jlsajfj/MTE380/README.md

# MTE380
STM32 Programming with NUCLEO-F401RE Board
