jlsajfj/MTE380/MainBoard/MainBoard.kicad_pcb

## KiCad design MainBoard/MainBoard.kicad_pcb (2024-03-13)

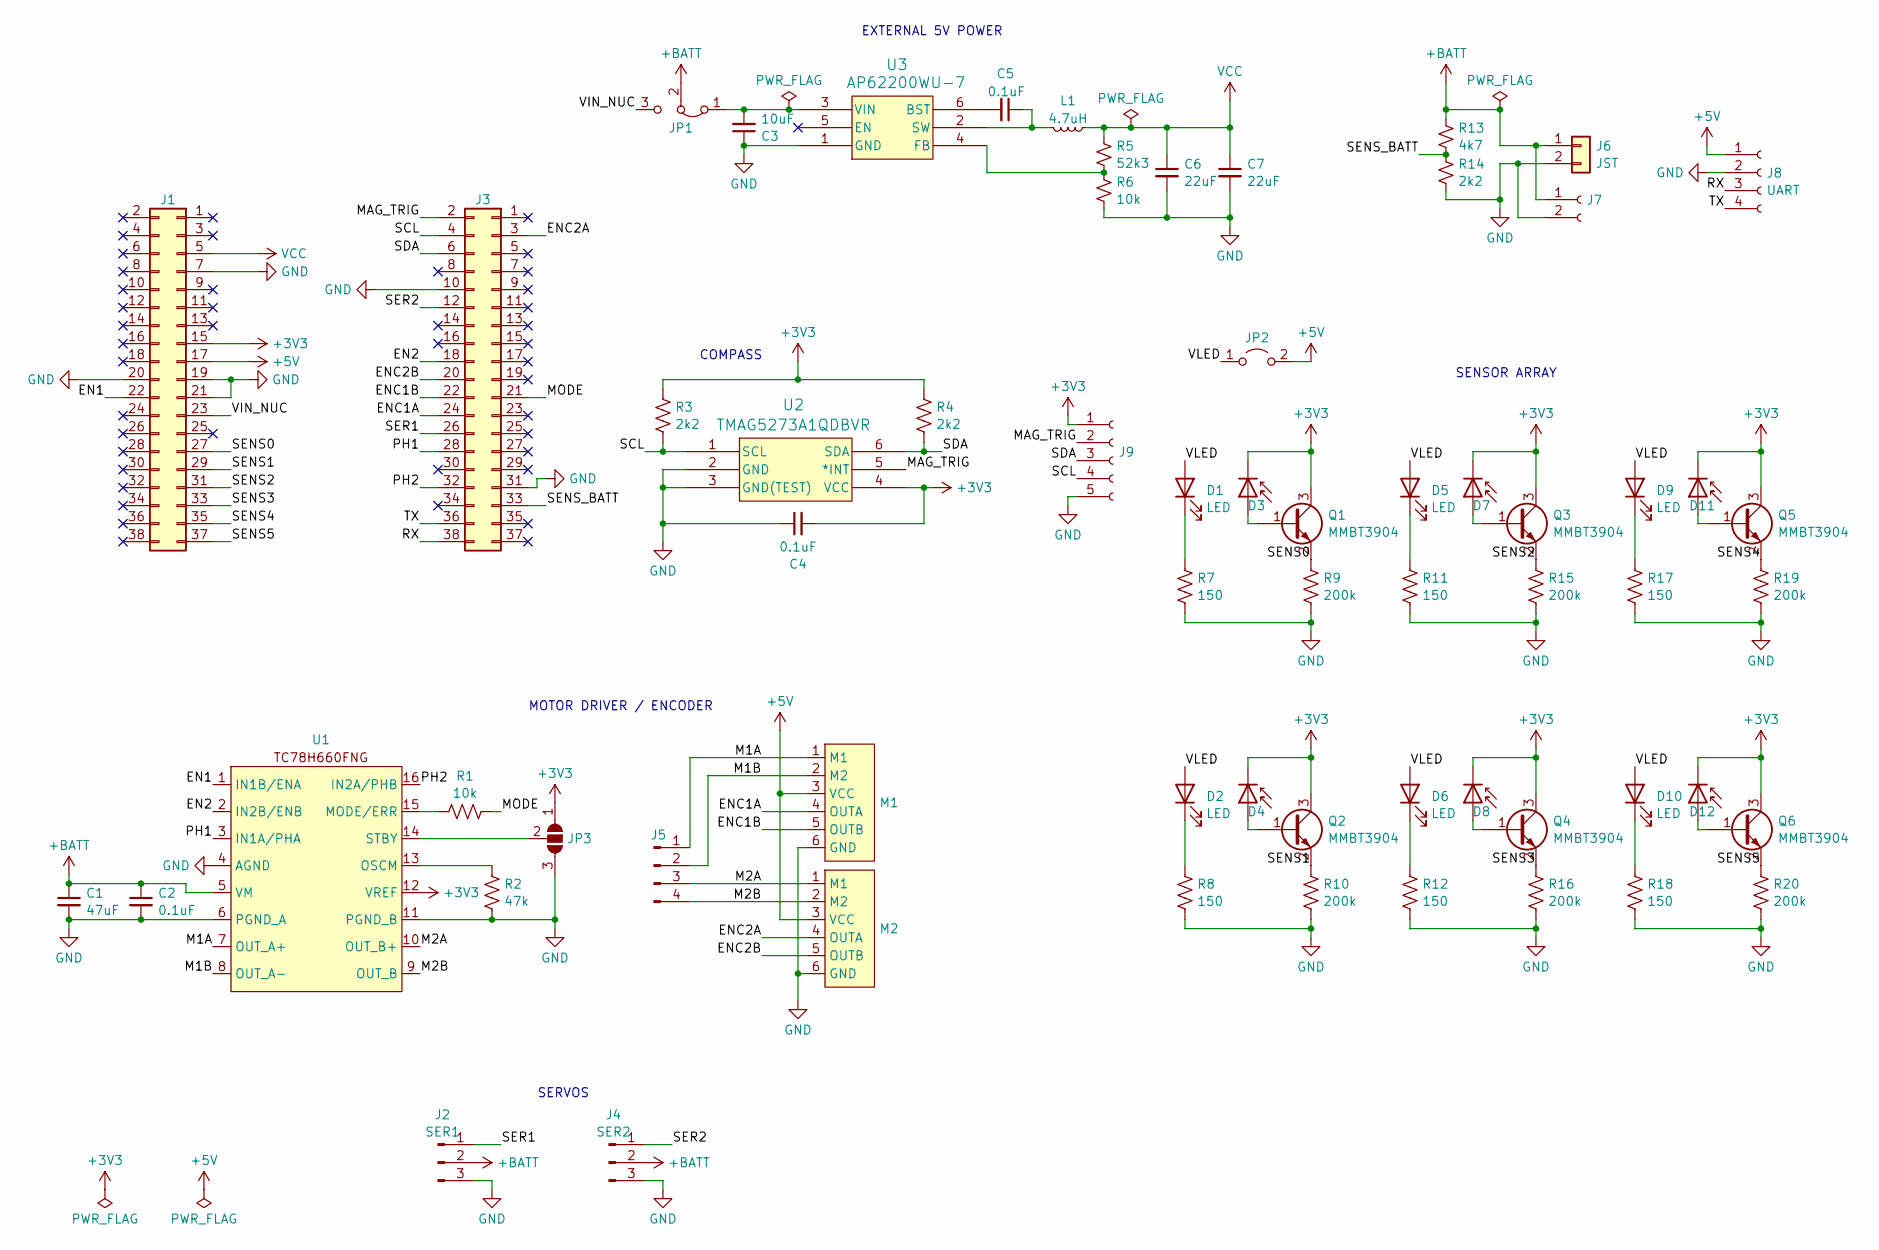
[picture p1: schematic MainBoard.kicad_sch]

Parts:
C1: 47uF; C_Radial_D5.0mm_H7.0mm_P2.00mm
C2, C4, C5: 0.1uF; C_0805_2012Metric_Pad1.18x1.45mm_HandSolder
C3: 10uF; C_0805_2012Metric_Pad1.18x1.45mm_HandSolder
C6, C7: 22uF; C_0805_2012Metric_Pad1.18x1.45mm_HandSolder
D1, D2, D5, D6, D9, D10: LED; LED_D3.0mm
D3, D4, D7, D8, D11, D12: D_Photo; LED_D5.0mm
J1, J3: Conn_02x19_Odd_Even; PinSocket_2x19_P2.54mm_Vertical
J2: SER1; PinHeader_1x03_P2.54mm_Vertical
J4: SER2; PinHeader_1x03_P2.54mm_Vertical
J5: Conn_01x04_Pin; PinHeader_1x04_P2.54mm_Horizontal
J6: JST; JST_PH_B2B-PH-K_1x02_P2.00mm_Vertical
J7: Conn_01x02_Socket; PinSocket_1x02_P2.54mm_Vertical
J8: UART; PinSocket_1x04_P2.54mm_Vertical
J9: Conn_01x05_Socket; PinHeader_1x05_P2.54mm_Vertical
JP1: Jumper_3_Bridged12; PinHeader_1x03_P2.54mm_Vertical
JP2: Jumper_2_Open; PinHeader_1x02_P2.54mm_Vertical
JP3: SolderJumper_3_Bridged12; SolderJumper-3_P2.0mm_Open_TrianglePad1.0x1.5mm
L1: 4.7uH; L_0805_2012Metric_Pad1.15x1.40mm_HandSolder
M1, M2: N20
Q1, Q2, Q3, Q4, Q5, Q6: MMBT3904; SOT-23_Handsoldering
R1, R6: 10k; R_0805_2012Metric_Pad1.20x1.40mm_HandSolder
R2: 47k; R_0805_2012Metric_Pad1.20x1.40mm_HandSolder
R3, R4, R14: 2k2; R_0805_2012Metric_Pad1.20x1.40mm_HandSolder
R5: 52k3; R_0805_2012Metric_Pad1.20x1.40mm_HandSolder
R7, R8, R11, R12, R17, R18: 150; R_0805_2012Metric_Pad1.20x1.40mm_HandSolder
R9, R10, R15, R16, R19, R20: 200k; R_0805_2012Metric_Pad1.20x1.40mm_HandSolder
R13: 4k7; R_0805_2012Metric_Pad1.20x1.40mm_HandSolder
U1: TSSOP-16_4.4x5mm_P0.65mm
U2: TMAG5273A1QDBVR; TSOT-23-6_HandSoldering
U3: AP62200WU-7; TSOT-23-6_HandSoldering

Connections:
+3V3: C4.2, D3.1 (K), D4.1 (K), D7.1 (K), D8.1 (K), D11.1 (K), D12.1 (K), J1.15, J9.1, JP3.1 (A), Q1.3 (C), Q2.3 (C), Q3.3 (C), Q4.3 (C), Q5.3 (C), Q6.3 (C), R3.1, R4.1, U1.12 (VREF), U2.4 (VCC)
+5V: J1.17, J8.1, JP2.2 (B), M1.3 (VCC), M2.3 (VCC)
+BATT: C1.1, C2.1, J2.2, J4.2, J6.1, J7.1, JP1.2 (C), R13.1, U1.5 (VM)
/EN1: J1.22, U1.1 (IN1B/ENA)
/EN2: J3.18, U1.2 (IN2B/ENB)
/ENC1A: J3.24, M1.4 (OUTA)
/ENC1B: J3.22, M1.5 (OUTB)
/ENC2A: J3.3, M2.4 (OUTA)
/ENC2B: J3.20, M2.5 (OUTB)
/M1A: J5.1, M1.1 (M1), U1.7 (OUT_A+)
/M1B: J5.2, M1.2 (M2), U1.8 (OUT_A-)
/M2A: J5.3, M2.1 (M1), U1.10 (OUT_B+)
/M2B: J5.4, M2.2 (M2), U1.9 (OUT_B)
/MAG_TRIG: J3.2, J9.2, U2.5 (*INT)
/MODE: J3.21, R1.2
/PH1: J3.28, U1.3 (IN1A/PHA)
/PH2: J3.32, U1.16 (IN2A/PHB)
/RX: J3.38, J8.3
/SCL: J3.4, J9.4, R3.2, U2.1 (SCL)
/SDA: J3.6, J9.3, R4.2, U2.6 (SDA)
/SENS0: J1.27, Q1.2 (E), R9.1
/SENS1: J1.29, Q2.2 (E), R10.1
/SENS2: J1.31, Q3.2 (E), R15.1
/SENS3: J1.33, Q4.2 (E), R16.1
/SENS4: J1.35, Q5.2 (E), R19.1
/SENS5: J1.37, Q6.2 (E), R20.1
/SENS_BATT: J3.33, R13.2, R14.1
/SER1: J2.1, J3.26
/SER2: J3.12, J4.1
/TX: J3.36, J8.4
/VIN_NUC: J1.23, JP1.3 (B)
/VLED: D1.2 (A), D2.2 (A), D5.2 (A), D6.2 (A), D9.2 (A), D10.2 (A), JP2.1 (A)
GND: C1.2, C2.2, C3.1, C4.1, C6.2, C7.2, J1.7, J1.19, J1.20, J1.21, J2.3, J3.10, J3.31, J4.3, J6.2, J7.2, J8.2, J9.5, JP3.3 (B), M1.6 (GND), M2.6 (GND), R2.2, R6.2, R7.2, R8.2, R9.2, R10.2, R11.2, R12.2, R14.2, R15.2, R16.2, R17.2, R18.2, R19.2, R20.2, U1.4 (AGND), U1.6 (PGND_A), U1.11 (PGND_B), U2.2 (GND), U2.3 (GND(TEST)), U3.1 (GND)
unnamed: D1.1 (K), R7.1
unnamed: D2.1 (K), R8.1
unnamed: D3.2 (A), Q1.1 (B)
unnamed: D4.2 (A), Q2.1 (B)
unnamed: D5.1 (K), R11.1
unnamed: D6.1 (K), R12.1
unnamed: D7.2 (A), Q3.1 (B)
unnamed: D8.2 (A), Q4.1 (B)
unnamed: D9.1 (K), R17.1
unnamed: D10.1 (K), R18.1
unnamed: D11.2 (A), Q5.1 (B)
unnamed: D12.2 (A), Q6.1 (B)
unnamed: C3.2, JP1.1 (A), U3.3 (VIN)
unnamed: JP3.2 (C), U1.14 (STBY)
unnamed: R1.1, U1.15 (MODE/ERR)
unnamed: R2.1, U1.13 (OSCM)
unnamed: C5.2, U3.6 (BST)
unnamed: R5.2, R6.1, U3.4 (FB)
unnamed: C5.1, L1.1, U3.2 (SW)
VCC: C6.1, C7.1, J1.5, L1.2, R5.1

Notes on the sheet:
COMPASS
EXTERNAL 5V POWER
SERVOS
MOTOR DRIVER / ENCODER
SENSOR ARRAY

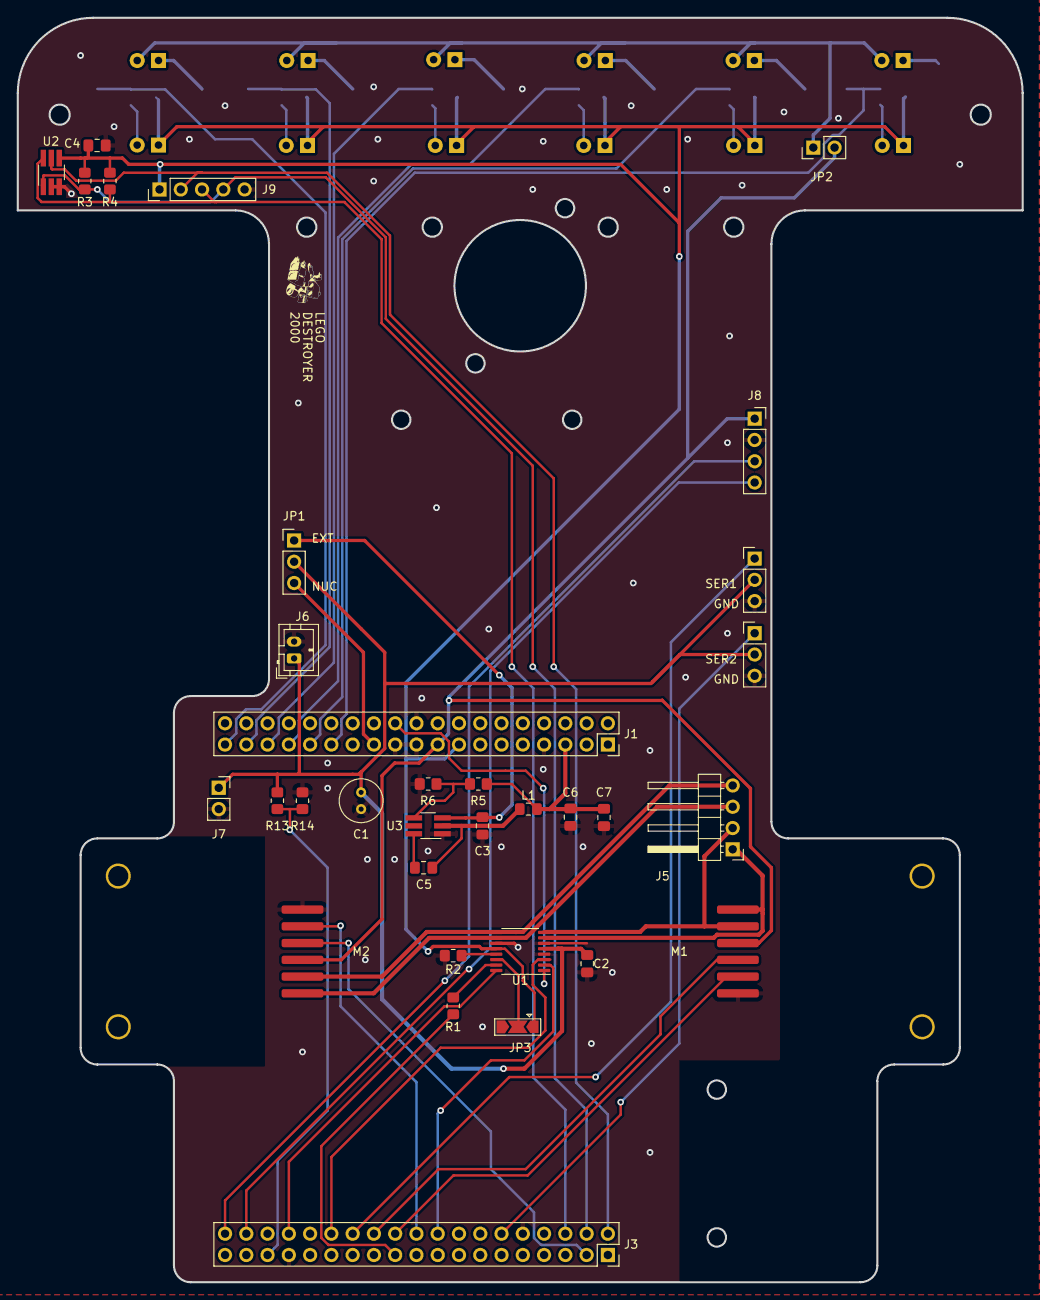
[picture p2: board MainBoard.kicad_pcb from above]

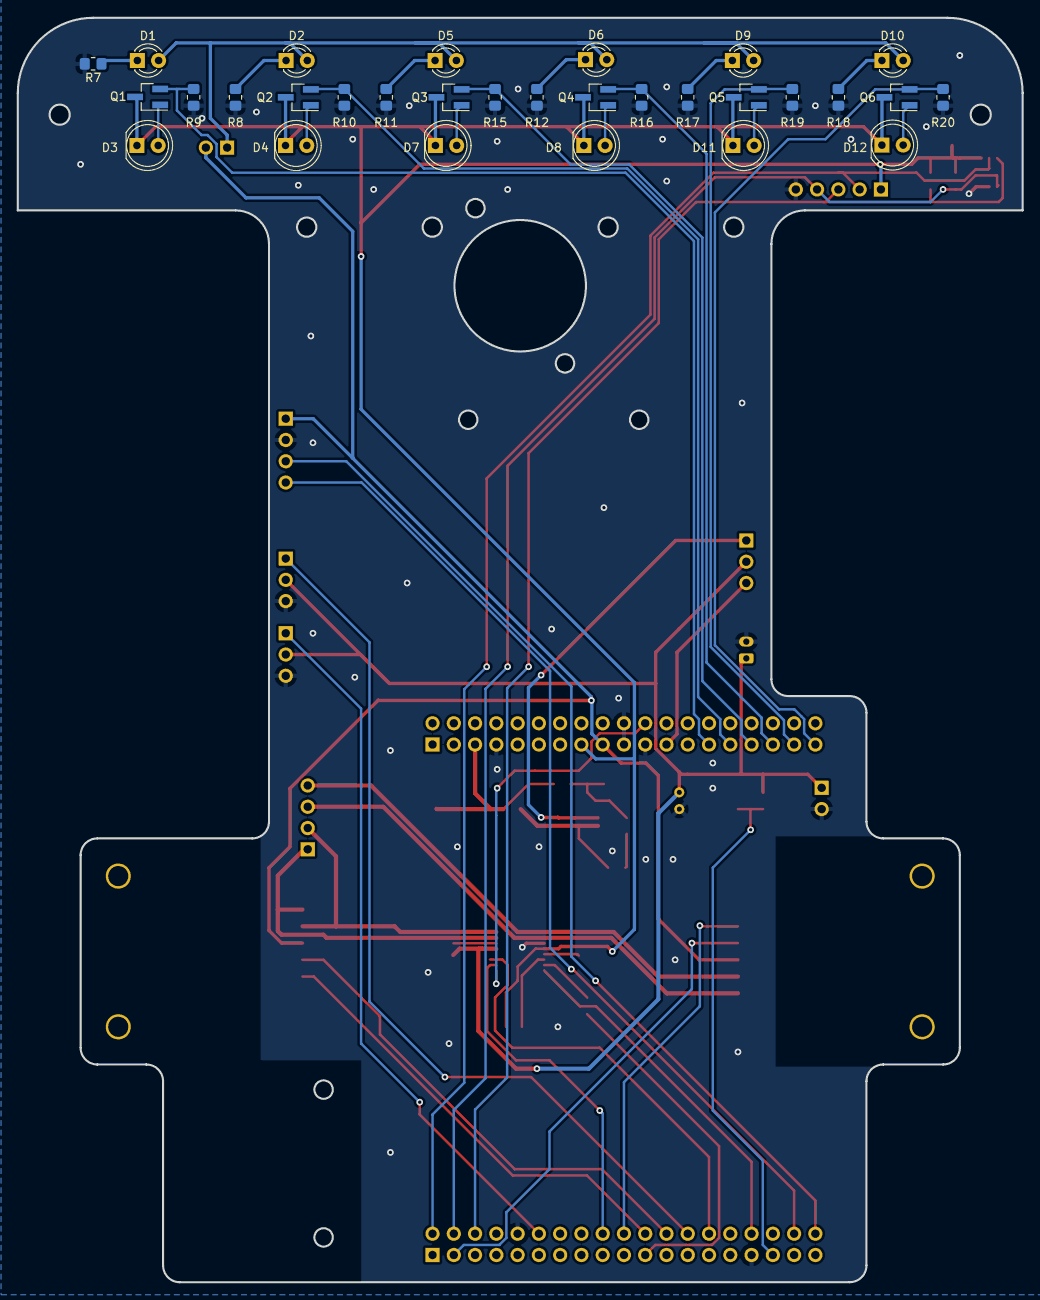
[picture p3: board MainBoard.kicad_pcb from below]

Board: 2 copper layers, 120.0 x 151.0 mm, 63 parts (30 on the bottom side), 53 nets.
