jlsajfj/MTE380/Core/Src/main.c

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
/* Includes ------------------------------------------------------------------*/
#include "main.h"
#include "adc.h"
#include "dma.h"
#include "i2c.h"
#include "tim.h"
#include "usart.h"
#include "gpio.h"

/* USER CODE BEGIN Includes */
#include "motor.h"
#include "command.h"
#include "control.h"
#include "sensor.h"
#include "flash.h"
#include "servo.h"
#include "compass.h"
#include "helper.h"
#include "config.h"
#include "state.h"
#include "telemetry.h"
#include "speed.h"
#include "music.h"
#include "button.h"

#include "stm32f4xx_hal.h"

#include <stdio.h>
/* USER CODE END Includes */


/* USER CODE BEGIN PV */
static volatile bool start_loop;
/* USER CODE END PV */

void SystemClock_Config(void);
/**
  * @brief  The application entry point.
  * @retval int
  */
int main(void)
{
  /* MCU Configuration--------------------------------------------------------*/

  /* Reset of all peripherals, Initializes the Flash interface and the Systick. */
  HAL_Init();

  /* Configure the system clock */
  SystemClock_Config();

  /* Initialize all configured peripherals */
  MX_GPIO_Init();
  MX_DMA_Init();
  MX_USART2_UART_Init();
  MX_ADC1_Init();
  MX_TIM3_Init();
  MX_TIM4_Init();
  MX_TIM2_Init();
  MX_TIM1_Init();
  MX_TIM5_Init();
  MX_I2C1_Init();
  MX_TIM9_Init();
  MX_TIM10_Init();
  /* USER CODE BEGIN 2 */

  config_load();
  sensor_init();
  button_init();
  compass_init();
  command_init();
  sm_init();
  control_init();
  servo_init();
  motor_init();
  speed_init();
  tele_init();
  music_init();

  HAL_TIM_Base_Start_IT(&htim5);

  /* USER CODE END 2 */

  /* Infinite loop */
  /* USER CODE BEGIN WHILE */
  while (1)
  {
    /* USER CODE END WHILE */

    /* USER CODE BEGIN 3 */
    while(!start_loop);
    start_loop = false;

    // order is important
    sensor_run();
    compass_run();
    button_run();
    command_run();
    sm_run();
    control_run();
    servo_run();
    motor_run();
    speed_run();
    tele_run();
    music_run();
    uart_flush();
  }
  /* USER CODE END 3 */
}

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
/* USER CODE BEGIN 4 */
void HAL_TIM_PeriodElapsedCallback(TIM_HandleTypeDef* htim) {
  if(htim == &htim5) {
    start_loop = true;
  }
  motor_timerIT(htim);
}
/* USER CODE END 4 */
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
