jlsajfj/MTE380/Core/Inc/main.h

#define B1_Pin GPIO_PIN_13
#define B1_GPIO_Port GPIOC
#define USART_TX_Pin GPIO_PIN_2
#define USART_TX_GPIO_Port GPIOA
#define USART_RX_Pin GPIO_PIN_3
#define USART_RX_GPIO_Port GPIOA
#define Sense_Batt_Pin GPIO_PIN_4
#define Sense_Batt_GPIO_Port GPIOC
#define Servo1_Pin GPIO_PIN_10
#define Servo1_GPIO_Port GPIOB
#define Servo2_Pin GPIO_PIN_13
#define Servo2_GPIO_Port GPIOB
#define MtrEnc_2A_Pin GPIO_PIN_6
#define MtrEnc_2A_GPIO_Port GPIOC
#define MtrEnc_2B_Pin GPIO_PIN_7
#define MtrEnc_2B_GPIO_Port GPIOC
#define Mag_Trig_Pin GPIO_PIN_9
#define Mag_Trig_GPIO_Port GPIOC
#define Mag_Trig_EXTI_IRQn EXTI9_5_IRQn
#define MtrEnc_1A_Pin GPIO_PIN_8
#define MtrEnc_1A_GPIO_Port GPIOA
#define MtrEnc_1B_Pin GPIO_PIN_9
#define MtrEnc_1B_GPIO_Port GPIOA
#define TMS_Pin GPIO_PIN_13
#define TMS_GPIO_Port GPIOA
#define TCK_Pin GPIO_PIN_14
#define TCK_GPIO_Port GPIOA
#define MtrDvr_Dir2_Pin GPIO_PIN_3
#define MtrDvr_Dir2_GPIO_Port GPIOB
#define MtrDvr_Dir1_Pin GPIO_PIN_4
#define MtrDvr_Dir1_GPIO_Port GPIOB
#define MtrDvr_PWM2_Pin GPIO_PIN_6
#define MtrDvr_PWM2_GPIO_Port GPIOB
#define MtrDrv_PWM1_Pin GPIO_PIN_7
#define MtrDrv_PWM1_GPIO_Port GPIOB
