jlsajfj/MTE380/Core/Src/usart.c

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
/* Includes ------------------------------------------------------------------*/
#include "usart.h"

/* USER CODE BEGIN 0 */
#include <stdbool.h>
#include <string.h>

#define UART_BUFF_SIZE 4096
static uint8_t uart_buff[UART_BUFF_SIZE * 2]; // two banks
static uint16_t uart_buff_len;
static uint8_t uart_buff_bank;
static volatile bool uart_dma_ready;
static uint16_t uart_fd;
/* USER CODE END 0 */

UART_HandleTypeDef huart2;
DMA_HandleTypeDef hdma_usart2_tx;

/* USART2 init function */

void MX_USART2_UART_Init(void)
{

  /* USER CODE BEGIN USART2_Init 0 */
  uart_buff_len = 0;
  uart_buff_bank = 0;
  uart_dma_ready = true;
  uart_fd = 1;
  /* USER CODE END USART2_Init 0 */

  huart2.Instance = USART2;
  huart2.Init.BaudRate = 115200;
  huart2.Init.WordLength = UART_WORDLENGTH_8B;
  huart2.Init.StopBits = UART_STOPBITS_1;
  huart2.Init.Parity = UART_PARITY_NONE;
  huart2.Init.Mode = UART_MODE_TX_RX;
  huart2.Init.HwFlowCtl = UART_HWCONTROL_NONE;
  huart2.Init.OverSampling = UART_OVERSAMPLING_16;
  if (HAL_UART_Init(&huart2) != HAL_OK)
  {
    Error_Handler();
  }
}

void HAL_UART_MspInit(UART_HandleTypeDef* uartHandle)
{

  GPIO_InitTypeDef GPIO_InitStruct = {0};
  if(uartHandle->Instance==USART2)
  {
    /* USART2 clock enable */
    __HAL_RCC_USART2_CLK_ENABLE();

    __HAL_RCC_GPIOA_CLK_ENABLE();
    /**USART2 GPIO Configuration
    PA2     ------> USART2_TX
    PA3     ------> USART2_RX
    */
    GPIO_InitStruct.Pin = USART_TX_Pin|USART_RX_Pin;
    GPIO_InitStruct.Mode = GPIO_MODE_AF_PP;
    GPIO_InitStruct.Pull = GPIO_NOPULL;
    GPIO_InitStruct.Speed = GPIO_SPEED_FREQ_LOW;
    GPIO_InitStruct.Alternate = GPIO_AF7_USART2;
    HAL_GPIO_Init(GPIOA, &GPIO_InitStruct);

    /* USART2 DMA Init */
    /* USART2_TX Init */
    hdma_usart2_tx.Instance = DMA1_Stream6;
    hdma_usart2_tx.Init.Channel = DMA_CHANNEL_4;
    hdma_usart2_tx.Init.Direction = DMA_MEMORY_TO_PERIPH;
    hdma_usart2_tx.Init.PeriphInc = DMA_PINC_DISABLE;
    hdma_usart2_tx.Init.MemInc = DMA_MINC_ENABLE;
    hdma_usart2_tx.Init.PeriphDataAlignment = DMA_PDATAALIGN_BYTE;
    hdma_usart2_tx.Init.MemDataAlignment = DMA_MDATAALIGN_BYTE;
    hdma_usart2_tx.Init.Mode = DMA_NORMAL;
    hdma_usart2_tx.Init.Priority = DMA_PRIORITY_VERY_HIGH;
    hdma_usart2_tx.Init.FIFOMode = DMA_FIFOMODE_DISABLE;
    if (HAL_DMA_Init(&hdma_usart2_tx) != HAL_OK)
    {
      Error_Handler();
    }

    __HAL_LINKDMA(uartHandle,hdmatx,hdma_usart2_tx);

    /* USART2 interrupt Init */
    HAL_NVIC_SetPriority(USART2_IRQn, 0, 0);
    HAL_NVIC_EnableIRQ(USART2_IRQn);
  }
}

void HAL_UART_MspDeInit(UART_HandleTypeDef* uartHandle)
{

  if(uartHandle->Instance==USART2)
  {
    /* Peripheral clock disable */
    __HAL_RCC_USART2_CLK_DISABLE();

    /**USART2 GPIO Configuration
    PA2     ------> USART2_TX
    PA3     ------> USART2_RX
    */
    HAL_GPIO_DeInit(GPIOA, USART_TX_Pin|USART_RX_Pin);

    /* USART2 DMA DeInit */
    HAL_DMA_DeInit(uartHandle->hdmatx);

    /* USART2 interrupt Deinit */
    HAL_NVIC_DisableIRQ(USART2_IRQn);
  }
}

/* USER CODE BEGIN 1 */
int _write(int file, const char *ptr, int len) {
  if(file != uart_fd) return len;

  if(UART_BUFF_SIZE - uart_buff_len < len) {
    return 0;
  }

  uint8_t *addr = uart_buff + uart_buff_len + uart_buff_bank * UART_BUFF_SIZE;
  uart_buff_len += len;

  if(len > 0) {
    memcpy(addr, ptr, len);
  }

  return len;
}

uint32_t uart_available(void) {
  return UART_BUFF_SIZE - uart_buff_len;
}

void uart_setTxFD(int fd) {
  uart_fd = fd;
}

void uart_flush(void) {
  if(uart_dma_ready && uart_buff_len > 0) {
    uint8_t bank = uart_buff_bank;
    uint16_t len = uart_buff_len;
    uart_buff_bank ^= 1;
    uart_buff_len = 0;
    uart_dma_ready = false;
    HAL_UART_Transmit_DMA(&huart2, uart_buff + bank * UART_BUFF_SIZE, len);
  }
}

void HAL_UART_TxCpltCallback(UART_HandleTypeDef * huart) {
  uart_dma_ready = true;
}
/* USER CODE END 1 */
