jlsajfj/MTE380/Core/Src/flash.c

#include "flash.h"

#include "stm32f4xx_hal.h"

#include <stdint.h>
#include <stddef.h>
#include <string.h>

__attribute__((__section__(".user_flash"))) static const uint8_t flash[128*1024];

HAL_StatusTypeDef flash_erase(void) {
  HAL_FLASH_Unlock();

  FLASH_EraseInitTypeDef erase_config;
  erase_config.TypeErase = FLASH_TYPEERASE_SECTORS;
  erase_config.Sector = 7;
  erase_config.NbSectors = 1;
  erase_config.VoltageRange = FLASH_VOLTAGE_RANGE_3;

  uint32_t page_error;
  HAL_StatusTypeDef status = HAL_FLASHEx_Erase(&erase_config, &page_error);

  HAL_FLASH_Lock();

  return status;
}

HAL_StatusTypeDef flash_write(flash_address_E address, void *data, size_t len) {
  HAL_FLASH_Unlock();

  HAL_StatusTypeDef status = HAL_OK;
  for(size_t i = 0; i < len && status == HAL_OK; i++) {
    status = HAL_FLASH_Program(FLASH_TYPEPROGRAM_BYTE, (uint32_t) &flash + address + i, ((uint8_t*) data)[i]);
  }

  HAL_FLASH_Lock();

  return status;
}

void flash_read(flash_address_E address, void *data, size_t len) {
  memcpy(data, flash + address, len);
}
