jlsajfj/MTE380/GUI/robot.py

import struct
import sys
import threading
import time
from enum import Enum

import serial

from helper import SB, Constants


class Robot:
    State = Enum("DecoderState", ["SYNCING", "START", "STREAM", "CONFIG", "SPEED"])

    def __init__(self, dn: str = "COM4", con: bool = False):
        self.config_names = Constants.CONFIG_NAMES
        self.dn = dn
        self.s = None
        self.sw = None
        self.send_lock = threading.Condition()
        self.debug = False
        self.state = Robot.State.SYNCING
        self.cmd_ack = False

        if con:
            self.connect()

    def bug(self, val):
        self.debug = val

    def connect(self) -> bool:
        if self.s is not None:
            return
        print("connecting to device")
        self.s = serial.Serial(self.dn, 115200)
        self.state = Robot.State.SYNCING
        print("bluetooth device has been connected")
        self.s.write(b"\n")

        # first sync
        self.send("stream 1", True)
        self.read()

    def read(self):  # https://stackoverflow.com/a/7155595
        if self.debug:
            print("reading")

        sync_cnt = 0

        while self.s is not None:
            if self.state == Robot.State.SYNCING:
                if self.s.in_waiting < 1:
                    time.sleep(0.1)
                    continue

                ack = self.s.read(1)[0]
                if ack == SB.SYNC.value:
                    sync_cnt += 1
                else:
                    sync_cnt = 0

                if sync_cnt >= Constants.SYNC_COUNT:
                    print("synced")
                    self.state = Robot.State.START

            elif self.state == Robot.State.START:
                if self.s.in_waiting < 1:
                    time.sleep(0.1)
                    continue

                start = self.s.read(1)[0]

                if start == SB.SYNC.value:
                    pass

                elif start == SB.ACK.value:
                    with self.send_lock:
                        self.cmd_ack = True
                        self.send_lock.notify()

                    return start, None

                elif start == SB.NACK.value:
                    with self.send_lock:
                        self.cmd_ack = False
                        self.send_lock.notify()

                    return start, None

                elif start == SB.STREAM.value:
                    self.state = Robot.State.STREAM

                elif start == SB.CONFIG.value:
                    self.state = Robot.State.CONFIG

                elif start == SB.SPEED.value:
                    self.state = Robot.State.SPEED

                else:
                    print(f"unknown start byte {start}")

                    with self.send_lock:
                        self.cmd_ack = False
                        self.send_lock.notify()

                    self.send("stream 1", True)
                    self.state = Robot.State.SYNCING

            elif self.state == Robot.State.STREAM:
                if self.s.in_waiting < 25:
                    time.sleep(0.1)
                    continue

                data = self.s.read(25)
                data_stream = dict(
                    zip(
                        [
                            "msl",
                            "msr",
                            "mtl",
                            "mtr",
                            "mel",
                            "mer",
                            "sta",
                            "pd0",
                            "pd1",
                            "pd2",
                            "pd3",
                            "pd4",
                            "pd5",
                            "bav",
                            "mag",
                            "tis",
                        ],
                        struct.unpack("<2b2b2iB6BBBI", data),
                    )
                )

                self.state = Robot.State.START
                return SB.STREAM, data_stream

            elif self.state == Robot.State.CONFIG:
                count = len(self.config_names)
                if self.s.in_waiting < count * 8:
                    time.sleep(0.1)
                    continue

                data = self.s.read(count * 8)
                config = dict(zip(self.config_names, struct.unpack(f"<{count}d", data)))

                self.state = Robot.State.START
                return SB.CONFIG, config

            elif self.state == Robot.State.SPEED:
                if self.s.in_waiting < 2:
                    time.sleep(0.1)
                    continue

                count = struct.unpack("<H", self.s.read(2))[0]
                if self.s.in_waiting < count * 5:
                    time.sleep(0.1)
                    continue

                data = self.s.read(count * 5)
                speed_points = [
                    {"count": p[0], "speed": p[1]}
                    for p in zip(*[iter(struct.unpack("<" + count * "iB", data))] * 2)
                ]

                self.state = Robot.State.START
                return SB.SPEED, speed_points

        self.state = Robot.State.SYNCING
        return SB.NACK, None

    def send(self, cmd: str, ignore_ack: bool = False, timeout: float = 1) -> bool:
        print("sending", cmd)
        self.s.write(cmd.encode() + b"\n")

        if not ignore_ack:
            with self.send_lock:
                self.cmd_ack = False
                self.send_lock.wait(timeout=timeout)

            return self.cmd_ack

        return True

    def disconnect(self):
        print("disconnecting")
        self.s.close()
        self.s = None


def main():
    if len(sys.argv) > 1:
        r = Robot(sys.argv[1])
    else:
        r = Robot()

    r.connect()

    r.send("get")

    for i in range(20):
        r.read()

    r.send("stream 0", True)
    r.disconnect()


if __name__ == "__main__":
    main()
