jlsajfj/MTE380/(commit log)

2024-01-15 Project Creation
    Created Project with Nucleo-F401RE Board
2024-01-19 Motor driver first push
    [MTE380-SW.cfg]
2024-01-20 motor test code
2024-01-21 Motor Driver getFault and setEnabled functions
2024-01-26 adc code
2024-01-29 calibration, command system, config
2024-01-29 move more parameters to config framework
2024-01-29 make motor speed a config
2024-02-02 make sensor gains symmetric
2024-02-02 laser scanner circuit files
    [LaserScanner.kicad_pcb, LaserScanner.kicad_sch]
2024-02-11 add pid controller
2024-02-11 Update Motor PWM
    change tim2 and tim3 pre-scalers. changed pre-scaler from 84 to 2, changed auto reload register from 100 to 1024
2024-02-11 Start Servo Code
    started some servo code, will need help to finish the firmware, need to add start and stop limits to command
2024-02-12 Bunch of Changes
    Updated Baud rate to 9600, created servo toggle and all other related functions
2024-02-13 experimental turn around and add servo support in commands
2024-02-15 add encoder support
2024-02-16 add pid for motor speed and position
2024-02-16 have pid_reset caller keep track of last output
2024-02-16 add interface to get motor count
2024-02-23 main board schematics
    [LaserScanner.kicad_pcb, LaserScanner.kicad_sch, MainBoard.kicad_pcb, MainBoard.kicad_sch]
2024-02-23 add external 5V regulator
    [MainBoard.kicad_sch]
2024-02-24 use dma for serial printing
2024-02-24 bump uart rate and handle burst transmission better
2024-02-26 mainboard layout
    [MainBoard.kicad_pcb, MainBoard.kicad_sch]
2024-02-27 add logo
    [MainBoard.kicad_pcb]
2024-02-27 update routing
    [MainBoard.kicad_pcb, MainBoard.kicad_sch]
2024-03-01 fix motor pid usage
    [command.c, config.c, control.c, control.h, motor.c, motor.h, pid.c, usart.c]
2024-03-01 poc pid tuning tool
2024-03-06 update to new board
2024-03-07 add lowpass to compass calibration; add demo code
2024-03-08 add multi servo support
2024-03-10 battery voltage; add idle mode to compass
2024-03-12 elliptic curve compass calibration
2024-03-13 update schematics datasheet link
    [MainBoard.kicad_pcb, MainBoard.kicad_sch]
2024-03-14 add stable margin as pid config
    clean up command parsing
    experiment variable speed control
2024-03-15 framework for connection
2024-03-19 starting backend threading
2024-03-20 fix new speed record; update states
    [config.c, control.c, motor.c, speed.c, state.c, state.h]
2024-03-21 add encoder steps to target detection
2024-03-21 basic graph for single wheel
2024-03-22 fix motor pwm output; change telemetry sync
    [command.c, control.c, motor.c, speed.c, speed.h, telemetry.c]
2024-03-23 use states to decode packets; improve firmware uart
2024-03-23 add button to clear charts
2024-03-23 ack print
2024-03-23 add typing and introduce helper class for Filters
2024-03-23 fix serial command reading
    [command.c, main.c]
2024-03-23 plot both wheels in tuner.py
2024-03-24 add slip factor to speed control encoder count
    [config.c, config.h, speed.c]
2024-03-24 better button behaviour
2024-03-26 adding path tracer
2024-03-28 only start tone timer when playing
2024-03-28 remove music commands, it burns the motor
    [command.c]
2024-03-29 unnormalize sensor weight
2024-03-30 fix python enum comparison
    [robot.py]
2024-03-31 add align command and sensor latching
2024-04-03 flipped motor
2024-04-03 switch to software pwm as walkaround for fried gpio pin
2024-04-04 update config and fix server
    [server.py]
2024-04-05 Lets burn the motor
    This reverts commit 16ad9728e0c84d04c44268af0af05d88e351d093.
    [command.c]
